Lutzion/ESP8266_Artnet_DMX_DC/HARDWARE.md

# HARDWARE

Soldering the hardware for the artnet-receiver is derived from my old [uDMX-modification](https://illutzmination.de/udmx-mod.html?&L=1).

More or less the hardware is the same as uDMX, only the ATMega8 is replaced by Wemos D1 mini (pro).

For security reasons the board has a galvanic isolation.

## The theory

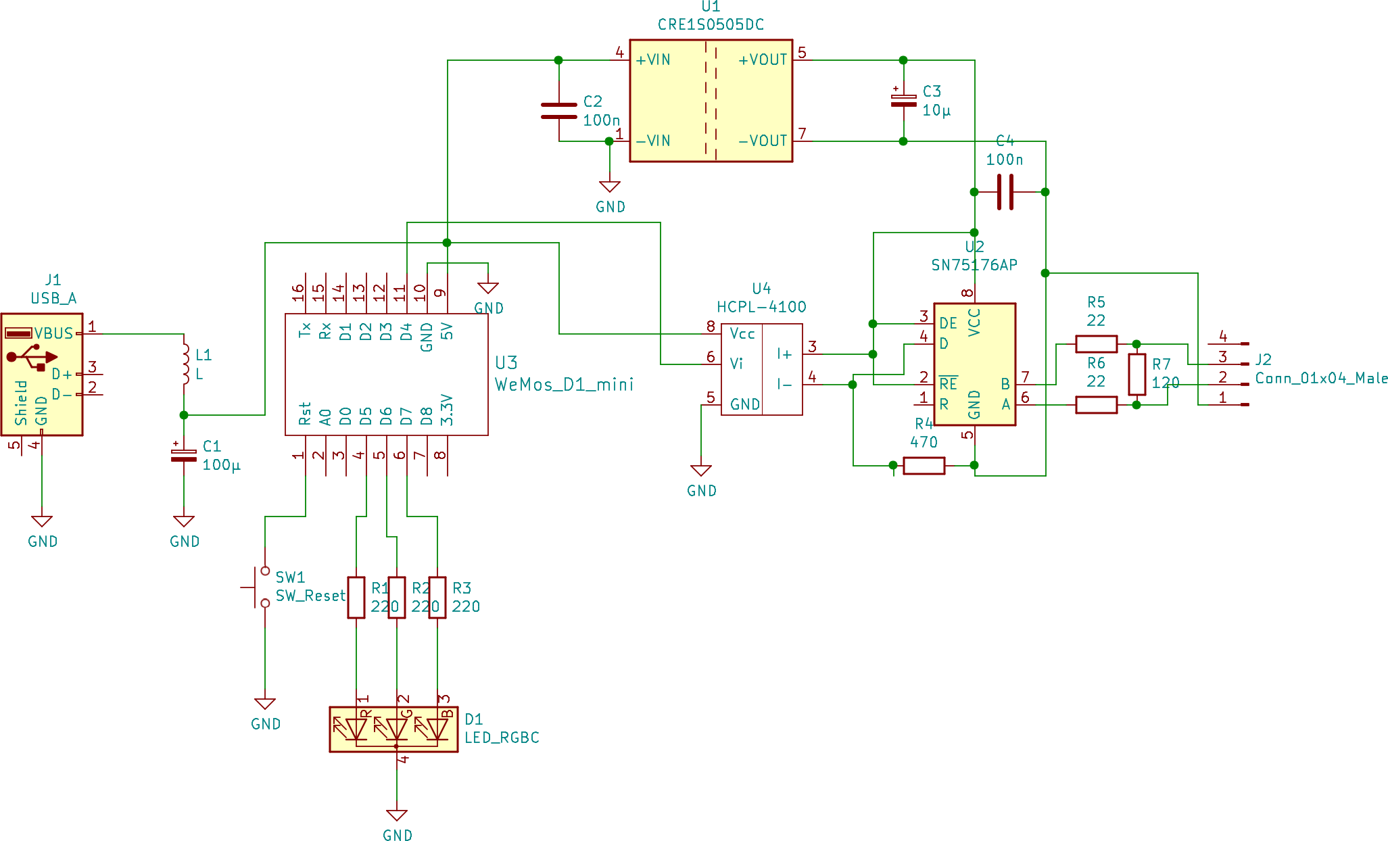
[picture p5: media/ESP8266_Artnet_DMX_DC-sheet.png]
esp8266_artnet_dmx sheet! esp8266_artnet_dmx sheet
  
The sheet

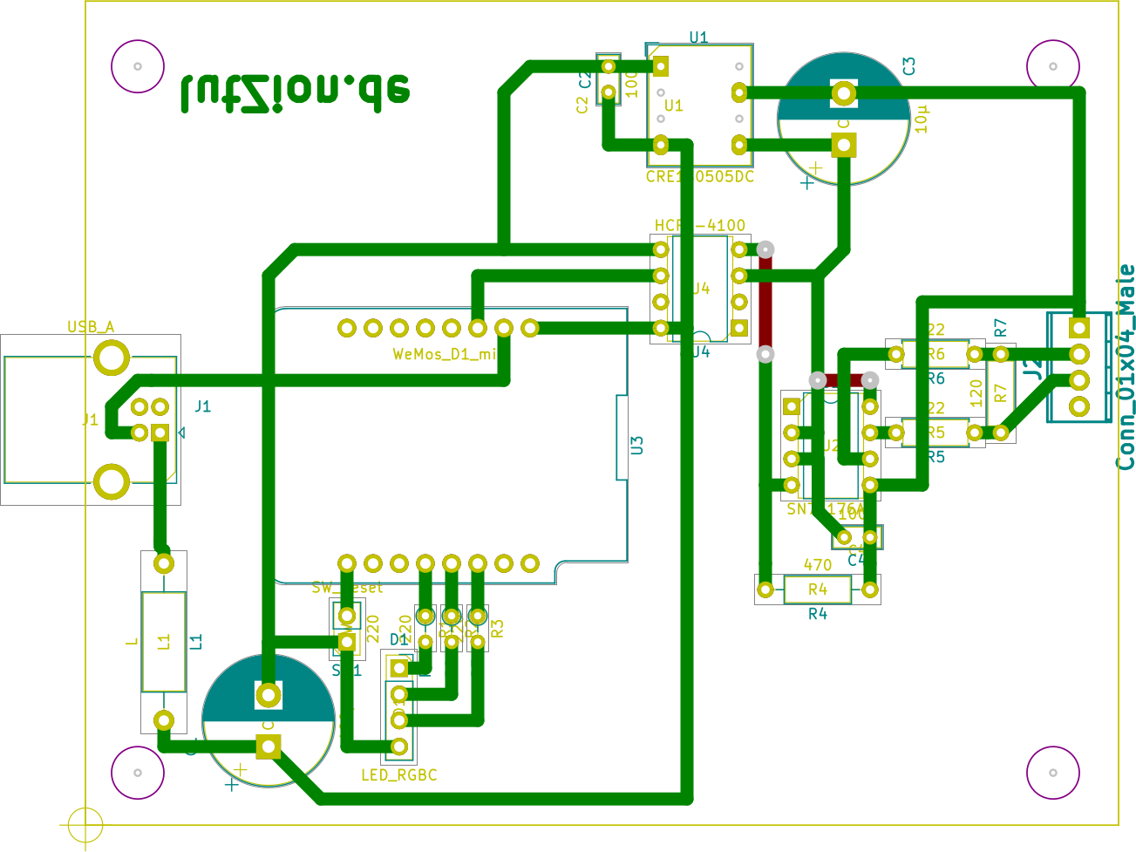
[picture p6: media/ESP8266_Artnet_DMX_DC-board.png]
esp8266_artnet_dmx board! esp8266_artnet_dmx board
  
The board

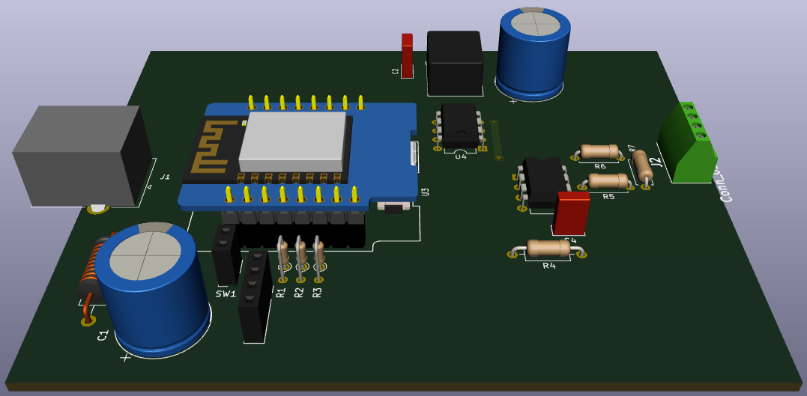
[picture p7: media/ESP8266_Artnet_DMX_DC-board_top.png]
esp8266_artnet_dmx 3d board top! esp8266_artnet_dmx board top
  
The board in 3D - top view

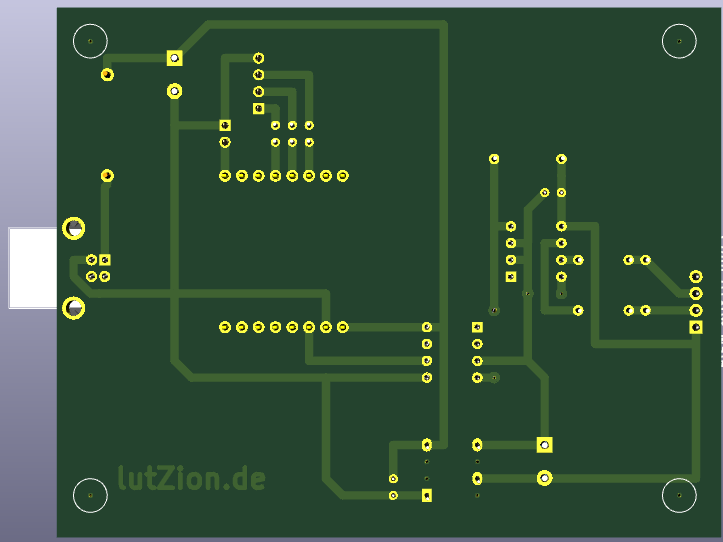
[picture p8: media/ESP8266_Artnet_DMX_DC-board_bottom.png]
esp8266_artnet_dmx 3d board bottom! esp8266_artnet_dmx 3d board bottom
  
The board in 3D - bottom view

## The real prototype

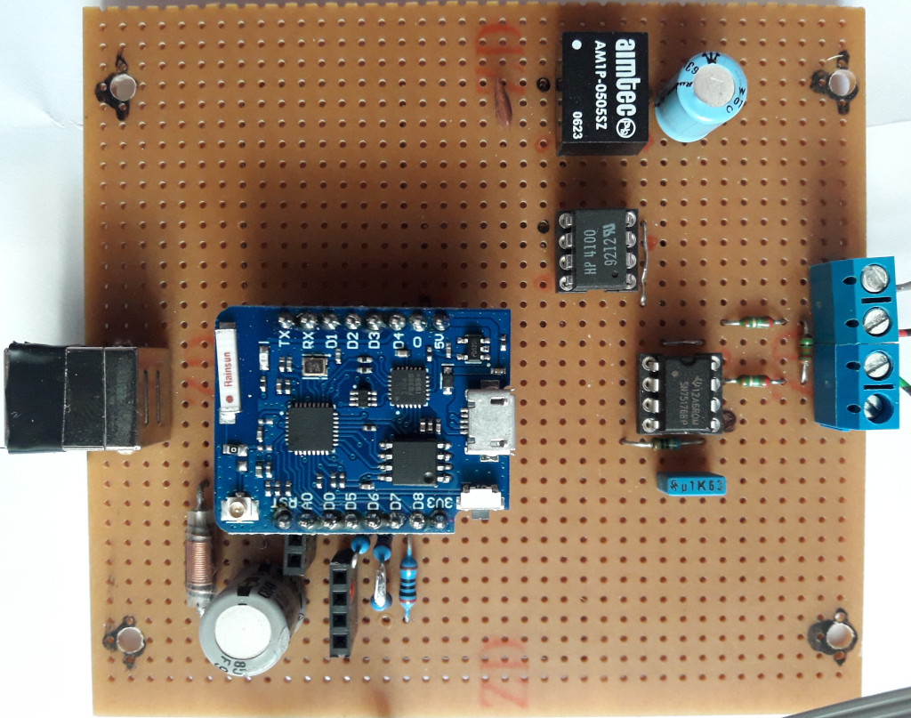
[picture p9: media/BoardTopView.jpg]
esp8266_artnet_dmx PCB Top View! esp8266_artnet_dmx pcb top view
  
Top view  
  
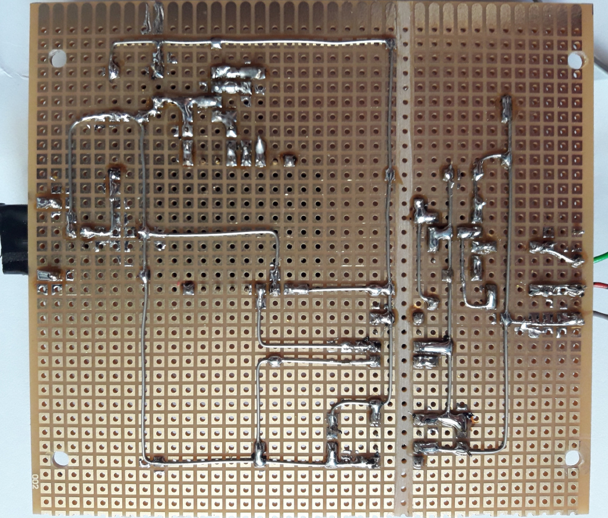
[picture p10: media/BoardBottomView.jpg]
esp8266_artnet_dmx PCB Bottom View! esp8266_artnet_dmx pcb bottom view
  
Bottom view  
  
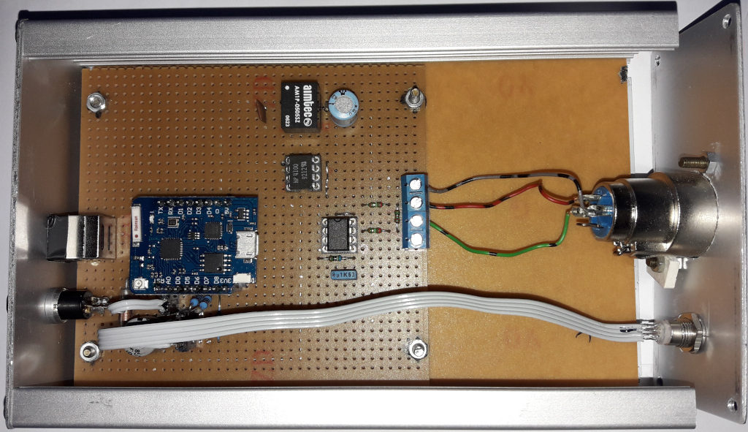
[picture p11: media/BoardInBox.jpg]
esp8266_artnet_dmx box view! esp8266_artnet_dmx pcb box view
  
board in box with dmx connector, RGB led and reset button  

[Back to main page](README.md)
