Lutzion/ESP8266_Artnet_DMX_DC/(commit log)

2020-05-26 led colors
2020-05-26 led colors documentation
2020-12-22 better sheet and board pictures
2020-12-23 added forgotten GND for Wemos
